2468shrm/Beam-Break/README.md

# Beam Break

This is a simple IR beam break board intended for direct interfacing
to a roboRIO DIO.

It has a status LED for visual debug and tuning/placement.
