2468shrm/Beam-Break/Beam Break.kicad_pcb

## KiCad design Beam Break.kicad_pcb (2024-01-02)

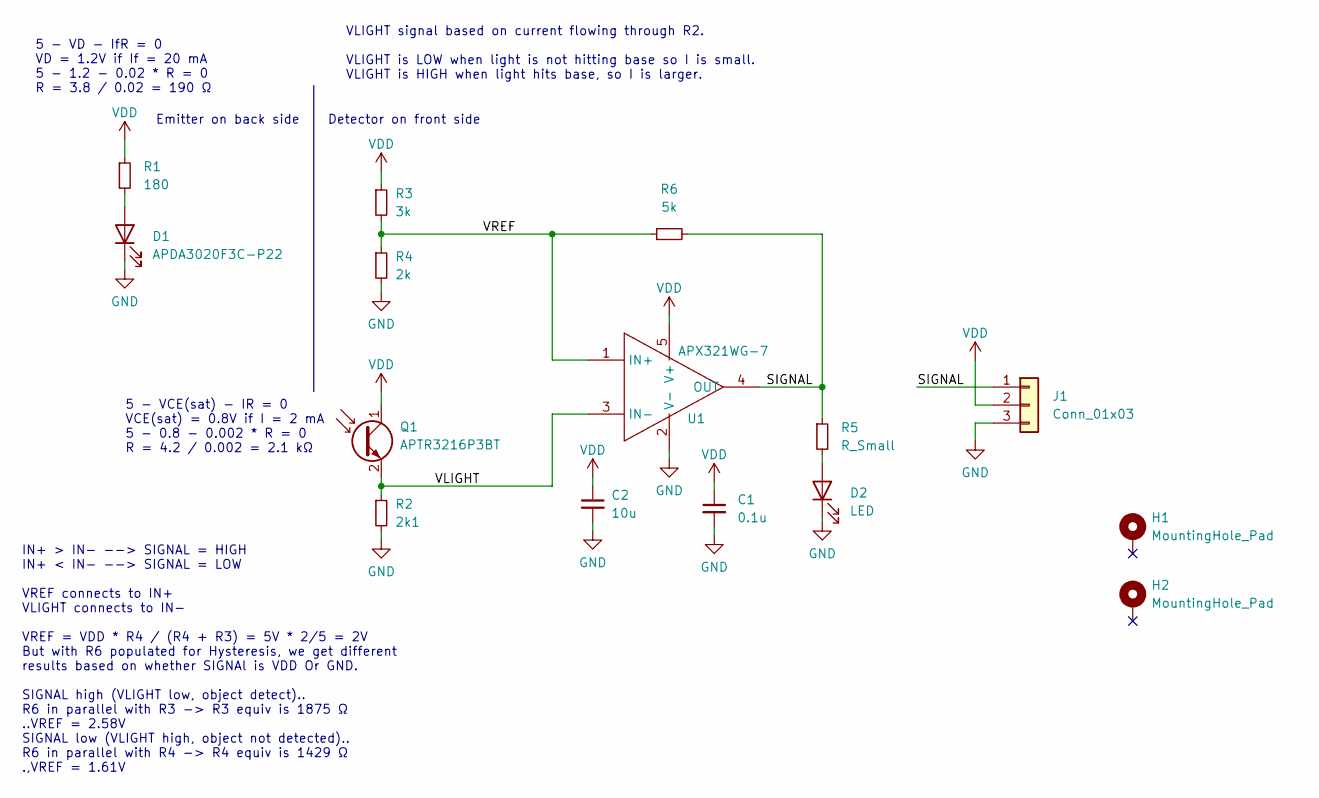
[picture p1: schematic Beam Break.kicad_sch]

Parts:
C1: 0.1u; C_1206_3216Metric
C2: 10u; C_1206_3216Metric
D1: APDA3020F3C-P22; APDA3020F3CP22
D2: LED; LED_1206_3216Metric
H1, H2: MountingHole_Pad; MountingHole_2.2mm_M2_DIN965_Pad
J1: Conn_01x03; PinSocket_1x03_P2.54mm_Vertical
Q1: APTR3216P3BT
R1: 180; R_1206_3216Metric
R2: 2k1; R_1206_3216Metric
R3: 3k; R_1206_3216Metric
R4: 2k; R_1206_3216Metric
R5: R_Small; R_1206_3216Metric
R6: 5k; R_1206_3216Metric
U1: APX321WG-7; SOT95P285X145-5N; Manufacturer_Part_Number APX321WG-7; Mouser Part Number 621-APX321WG-7

Connections:
/SIGNAL: J1.1, R5.1, R6.2, U1.4 (OUT)
/VLIGHT: Q1.2 (E), R2.1, U1.3 (IN-)
/VREF: R3.2, R4.1, R6.1, U1.1 (IN+)
GND: C1.2, C2.2, D1.1 (K), D2.1 (K), J1.3, R2.2, R4.2, U1.2 (V-)
unnamed: D1.2 (A), R1.2
unnamed: D2.2 (A), R5.2
VDD: C1.1, C2.1, J1.2, Q1.1 (C), R1.1, R3.1, U1.5 (V+)

Notes on the sheet:
5 - VCE(sat) - IR = 0 VCE(sat) = 0.8V if I = 2 mA 5 - 0.8 - 0.002 * R = 0 R = 4.2 / 0.002 = 2.1 kΩ
Detector on front side
Emitter on back side
IN+ > IN- --> SIGNAL = HIGH IN+ < IN- --> SIGNAL = LOW VREF connects to IN+ VLIGHT connects to IN- VREF = VDD * R4 / (R4 + R3) = 5V * 2/5 = 2V But with R6 populated for Hysteresis, we get different results based on whether SIGNAl is VDD Or GND. SIGNAL high (VLIGHT low, object detect).. R6 in parall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
VLIGHT signal based on current flowing through R2. VLIGHT is LOW when light is not hitting base so I is small. VLIGHT is HIGH when light hits base, so I is larger.
5 - VD - IfR = 0 VD = 1.2V if If = 20 mA 5 - 1.2 - 0.02 * R = 0 R = 3.8 / 0.02 = 190 Ω

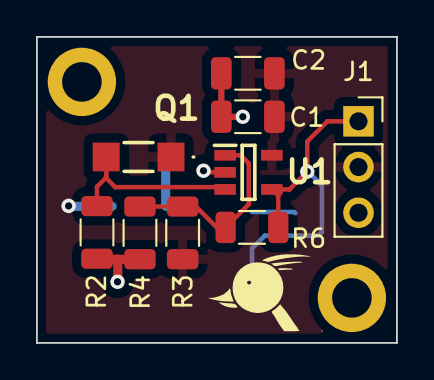
[picture p2: board Beam Break.kicad_pcb from above]

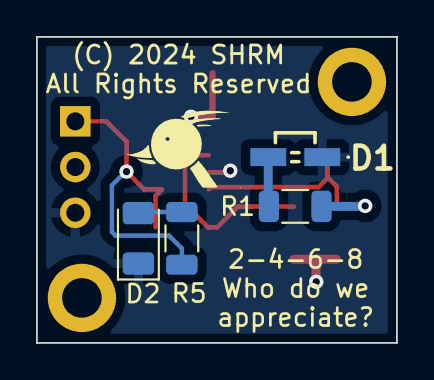
[picture p3: board Beam Break.kicad_pcb from below]

Board: 2 copper layers, 20.0 x 17.0 mm, 15 parts (4 on the bottom side), 7 nets.
