2468shrm/Beam-Break/(notices)

Notices in the files:
Beam Break.kicad_pcb:
(C) 2024 SHRM
All Rights Reserved
